FarwayDot/Cooling-System/ConsorcioMedico_Refrigeradora.kicad_pcb

## KiCad design ConsorcioMedico_Refrigeradora.kicad_pcb (2024-01-05)

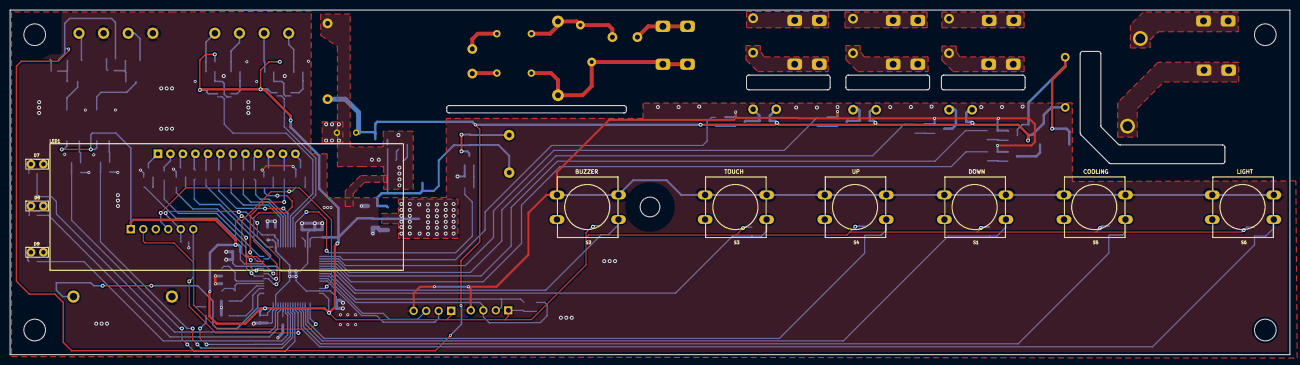
[picture p1: board ConsorcioMedico_Refrigeradora.kicad_pcb from above]

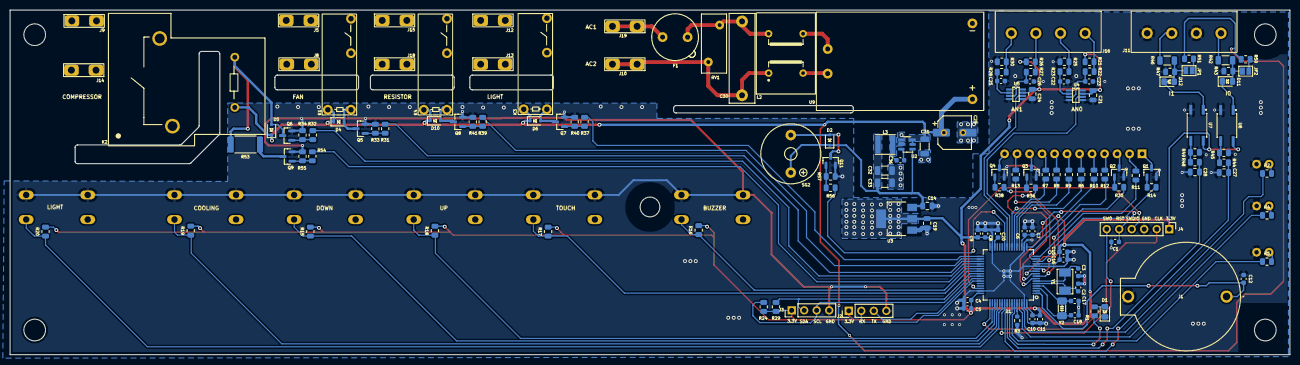
[picture p2: board ConsorcioMedico_Refrigeradora.kicad_pcb from below]

Board: 2 copper layers, 260.0 x 70.0 mm, 156 parts (144 on the bottom side), 116 nets.

Parts:
C1, C4, C6, C8, C10, C12, C15: 100nF 50V; C_0603_1608Metric
C2, C3: 30pF 50V; C_0603_1608Metric
C5, C7, C9, C11: 10nF 50V; C_0603_1608Metric
C14: 1uF 10V; C_0805_2012Metric
C16, C22, C23, C25, C26: 1uF 50V; C_0603_1608Metric
C17, C18: 15pF 10V; C_0603_1608Metric
C19: 4.7uF 5V; C_0805_2012Metric
C20: 2.2uF 50V; C_0603_1608Metric
C21, C24: 100nF 50V; C_0805_2012Metric
C27, C28: 1uF 50V; C_0805_2012Metric
C29: 100uF 25V; CP_Elec_6.3x7.7
C30: 0.1uF 275VAC; C_Rect_L18.0mm_W5.0mm_P15.00mm_FKS3_FKP3
C31: 10uF; C_1206_3216Metric
C32, C33: 22uF; C_1206_3216Metric
C36: 100nF; C_0603_1608Metric
D1: LED_0805
D2, D4, D5, D6, D10: 1N4148WS; D_SOD-323
D7, D8, D9: L-144IDT; LED_3.9x1.9mm
D11, D12: RED; LED_0805
F1: 250VAC 0.5AAC; Fuseholder_TR5_Littelfuse_No560_No460
J1: BatteryHolder; BatteryHolder_DS1092_04_B6P
J2, J3: USART; PinHeader_1x04_P2.54mm_Vertical
J4: SWD; PinHeader_1x06_P2.54mm_Vertical
J5, J8: Evap_fan; Solder-Terminal_FS1536_6.3x0.8mm_NINIGI
J6, J7: Screw_Terminal_01x01; Pad_0.7mm_1.3mm
J9, J14: Compress; Solder-Terminal_FS1536_6.3x0.8mm_NINIGI
J10, J19: AC; Solder-Terminal_FS1536_6.3x0.8mm_NINIGI
J11: Digital; Terminal-Block_XY2500V-B_4P_P5.0mm_XINYA
J12, J13: Light; Solder-Terminal_FS1536_6.3x0.8mm_NINIGI
J15, J18: Resistor; Solder-Terminal_FS1536_6.3x0.8mm_NINIGI
J16: Analog; Terminal-Block_XY2500V-B_4P_P5.0mm_XINYA
JP1, JP2: Bridge1; SolderJumper-2_P1.3mm_Open_Pad1.0x1.5mm
K1, K3, K4: HF46F-G/012-HS1T; Relay_HONGFA_SPST-NO_20.5x7x15.3mm
K2: AZ2150-1A-12DEF; Relay_Zettler_SPST-NO_31.8x26.9x19.1mm
L2: UU9.8-10mH
L3: YNR4030-4R7M 4.7uF; Inductor_YNR4030_4x4x3mm_YJYCOIN
LED1: LFD080AUE-103A-0
Q1, Q2, Q3, Q4: MMBT3904; SOT-23
Q5, Q6, Q7, Q8, Q9, Q11: BSS806; SOT-23
R1, R14, R22, R23, R27, R28, R35, R36, R38, R44, R48: 1k; R_0805_2012Metric
R2, R4, R5: 330; R_0805_2012Metric
R3: 10k; R_0603_1608Metric
R6, R7, R8, R9, R10, R11, R12, R13: 120R; R_0805_2012Metric
R15, R16, R17, R18, R19, R20: 10k; R_0805_2012Metric
R21, R26: 3.9k; R_0805_2012Metric
R24, R29: 2.2k; R_0805_2012Metric
R25, R30: 2.7k; R_0805_2012Metric
R31, R32, R37, R39, R54, R56: 220R; R_0805_2012Metric
R33, R34, R40, R41, R55, R57: 10K; R_0805_2012Metric
R42, R46: 6.2k; R_1206_3216Metric
R43, R47: 2.4k; R_0805_2012Metric
R45, R49: 22k; R_0805_2012Metric
R50, R51: 2k; R_0805_2012Metric
R53: 150R; R_2512_6332Metric
RV1: RM10D561KD24E100; RV_Disc_D12mm_W5.1mm_P7.5mm
S1: Buzz; SW_PUSH-12mm-H
S2: Touch; SW_PUSH-12mm-H
S3: Up; SW_PUSH-12mm-H
S4: Down; SW_PUSH-12mm-H
S5: Cooling; SW_PUSH-12mm-H
S6: Light; SW_PUSH-12mm-H
SG2: F_TMB
U1: STM32F411RETx; LQFP-64_10x10mm_P0.5mm
U2: AP63205WU; TSOT-23-6
U3: LDL1117; SOT-223-3_TabPin2
U4, U5: INA350; SOT-23-8
U6, U7: LTV-357T; SO-4_4.4x3.6mm_P2.54mm
U9: HLK-PMx; HLK-PM12
Y1: 8Mhz; Crystal_SMD_5032-2Pin_5.0x3.2mm
Y2: 32.768khz/12.5pF; Crystal_SMD_3215-2P_32.768khz

Connections:
+3.3V: C4.1, C5.1, C6.1, C7.1, C8.1, C9.1, C10.1, C11.1, C15.1, C16.1, C19.1, C21.1, C24.1, J2.1, J3.1, J4.1, R15.2, R16.2, R17.2, R18.2, R19.2, R20.2, R21.1, R24.2, R26.1, R29.2, U1.13 (VDDA), U1.19 (VDD), U1.32 (VDD), U1.48 (VDD), U1.64 (VDD), U3.2 (VO), U4.7 (V+), U5.7 (V+), U6.4, U7.4
+5V: C14.1, C32.1, C33.1, D2.1 (K), L3.2, SG2.+, U2.1 (FB), U3.3 (VI)
+12V: C29.1, C31.1, D4.1 (K), D5.1 (K), D6.1 (K), D10.1 (K), J6.1, K1.2, K2.2, K3.2, K4.2, R50.2, R51.2, U2.2 (EN), U2.3 (IN), U9.3 (+)
+BATT: C12.1, J1.1, U1.1 (VBAT)
A: R13.1, U1.14 (PA0)
B: R12.1, U1.15 (PA1)
Button_Buzzer: R16.1, S2.1, U1.38 (PC7)
Button_Cooling: R19.1, S5.1, U1.53 (PC12)
Button_Down: R15.1, S1.1, U1.52 (PC11)
Button_Light: R20.1, S6.1, U1.54 (PD2)
Button_Touch: R17.1, S3.1, U1.39 (PC8)
Button_Up: R18.1, S4.1, U1.51 (PC10)
C: R11.1, U1.16 (PA2)
D: R10.1, U1.17 (PA3)
DIG1: R14.1, U1.11 (PC3)
DIG2: R35.1, U1.10 (PC2)
DIG3: R36.1, U1.9 (PC1)
DIG4: R38.1, U1.8 (PC0)
DIG_IN_0: C27.1, R44.2, U1.56 (PB4)
DIG_IN_1: C28.1, R48.2, U1.57 (PB5)
DP: R6.1, U1.23 (PA7)
E: R9.1, U1.20 (PA4)
F: R8.1, U1.21 (PA5)
G: R7.1, U1.22 (PA6)
GND: C1.2, C2.2, C3.2, C4.2, C5.2, C6.2, C7.2, C8.2, C9.2, C10.2, C11.2, C12.2, C14.2, C15.2, C16.2, C17.2, C18.2, C19.2, C20.2, C21.2, C22.2, C23.2, C24.2, C25.2, C26.2, C27.2, C28.2, C29.2, C31.2, C32.2, C33.2, D1.1 (K), D7.K, D8.K, D9.K, J1.2, J2.4, J3.4, J4.3, J7.1, J11.2, J11.4, Q1.2 (E), Q2.2 (E), Q3.2 (E), Q4.2 (E), Q5.2 (S), Q6.2 (S), Q7.2 (S), Q8.2 (S), Q9.2 (S), Q11.2 (S), R3.2, R25.2, R30.2, R33.1, R34.1, R40.1, R41.1, R43.2, R45.2, R47.2, R49.2, R55.1, R57.1, S1.3, S1.4, S2.3, S2.4, S3.3, S3.4, S4.3, S4.4, S5.3, S5.4, S6.3, S6.4, U1.12 (VSSA), U1.18 (VSS), U1.31 (VSS), U1.47 (VSS), U1.63 (VSS), U2.4 (GND), U3.1 (ADJ), U4.4 (V-), U4.5 (REF), U5.4 (V-), U5.5 (REF), U6.2, U7.2, U9.4 (-)
I0: J11.1, R42.1
I1: J11.3, R46.1
I2C3_SCL: J3.3, R24.1, U1.41 (PA8)
I2C3_SDA: J3.2, R29.1, U1.40 (PC9)
LED_Defrost: R2.1, U1.62 (PB9)
LED_Door: R4.1, U1.61 (PB8)
LED_Status: R1.1, U1.58 (PB6)
LED_TempAlarm: R5.1, U1.59 (PB7)
MCU_RX1: J2.2, U1.43 (PA10)
MCU_TX1: J2.3, U1.42 (PA9)
unnamed: C30.1, F1.2, L2.4, RV1.1
unnamed: D1.2 (A), R1.2
unnamed: D2.2 (A), Q11.3 (D), SG2.-
unnamed: D4.2 (A), K1.1, Q5.3 (D)
unnamed: D5.2 (A), K2.1, Q6.3 (D), R53.1
unnamed: D6.2 (A), K3.1, Q7.3 (D)
unnamed: D7.A, R2.2
unnamed: D8.A, R4.2
unnamed: D9.A, R5.2
unnamed: D10.2 (A), K4.1, Q8.3 (D)
unnamed: D11.2 (A), JP2.2 (B), R42.2, R43.1
unnamed: D11.1 (K), U6.1
unnamed: D12.2 (A), JP1.2 (B), R46.2, R47.1
unnamed: D12.1 (K), U7.1
unnamed: J5.1, K1.4
unnamed: J8.1, K1.3
unnamed: J9.1, K2.4
unnamed: C30.2, J10.1, L2.1, RV1.2
unnamed: J12.1, K3.4
unnamed: J13.1, K3.3
unnamed: J14.1, K2.3
unnamed: J15.1, K4.4
unnamed: J16.1, R21.2, R22.1
unnamed: J16.2, R23.1, R25.1
unnamed: J16.3, R26.2, R27.1
unnamed: J16.4, R28.1, R30.1
unnamed: J18.1, K4.3
unnamed: F1.1, J19.1
unnamed: JP1.1 (A), R51.1
unnamed: JP2.1 (A), R50.1
unnamed: LED1.11 (A), R13.2
unnamed: LED1.4 (B), R12.2
unnamed: LED1.2 (C), R11.2
unnamed: LED1.5 (D), R10.2
unnamed: LED1.1 (DIG1), Q1.3 (C)
unnamed: LED1.3 (DIG2), Q2.3 (C)
unnamed: LED1.10 (DIG3), Q3.3 (C)
unnamed: LED1.12 (DIG4), Q4.3 (C)
unnamed: LED1.6 (DP), R6.2
unnamed: LED1.7 (E), R9.2
unnamed: LED1.8 (F), R8.2
unnamed: LED1.9 (G), R7.2
unnamed: Q1.1 (B), R14.2
unnamed: Q2.1 (B), R35.2
unnamed: Q3.1 (B), R36.2
unnamed: Q4.1 (B), R38.2
unnamed: Q5.1 (G), R31.2, R33.2
unnamed: Q6.1 (G), R32.2, R34.2
unnamed: Q7.1 (G), R37.2, R40.2
unnamed: Q8.1 (G), R39.2, R41.2
unnamed: Q9.3 (D), R53.2
unnamed: Q9.1 (G), R54.2, R55.2
unnamed: Q11.1 (G), R56.2, R57.2
unnamed: R44.1, R45.1, U6.3
unnamed: R48.1, R49.1, U7.3
unnamed: R3.1, U1.60 (BOOT0)
unnamed: C18.1, U1.3 (PC14), Y2.2
unnamed: C17.1, U1.4 (PC15), Y2.1
unnamed: C2.1, U1.5 (PH0), Y1.1
unnamed: C3.1, U1.6 (PH1), Y1.2
unnamed: C20.1, U1.30 (VCAP1)
unnamed: C36.2, U2.6 (BST)
unnamed: C36.1, L3.1, U2.5 (SW)
unnamed: C23.1, R22.2, U4.3 (+)
unnamed: C22.1, R23.2, U4.2 (-)
unnamed: C26.1, R27.2, U5.3 (+)
unnamed: C25.1, R28.2, U5.2 (-)
unnamed: L2.3, U9.1 (AC1)
unnamed: L2.2, U9.2 (AC2)
RESET: C1.1, J4.5, U1.7 (NRST)
RTD1: U1.24 (PC4), U4.6
RTD2: U1.25 (PC5), U5.6
Relay_Calefac: R39.1, U1.34 (PB13)
Relay_Compressor: R32.1, U1.36 (PB15)
Relay_Compressor_Save: R54.1, U1.37 (PC6)
Relay_Fan: R31.1, U1.35 (PB14)
Relay_Light: R37.1, U1.33 (PB12)
Relay_On: R56.1, U1.26 (PB0)
SWCLK: J4.2, U1.49 (PA14)
SWDIO: J4.4, U1.46 (PA13)
SWO: J4.6, U1.55 (PB3)
