FarwayDot/Cooling-System/(commit log)

2023-12-28 Primer commit con el proyecto vacío
    [ConsorcioMedico_Refrigeradora.kicad_pcb, ConsorcioMedico_Refrigeradora.kicad_sch]
2023-12-28 SCH: Se añadió el uC, pulsadores, display, fuente, relays (aunque falta escoger el correcto)
    [ConsorcioMedico_Refrigeradora.kicad_sch]
2023-12-29 Commit de guardado
    [ConsorcioMedico_Refrigeradora.kicad_sch]
2023-12-30 SCH: Aún queda resolver la entrada digital para el switch y la fuente de voltaje. PCB: Se están acomodando los componentes
    [ConsorcioMedico_Refrigeradora.kicad_pcb, ConsorcioMedico_Refrigeradora.kicad_sch]
2023-12-30 SCH: Se guarda antes de crer las hojas jerárquicas
    [ConsorcioMedico_Refrigeradora.kicad_sch]
2023-12-30 SCH: Falta definir los capacitores de entrada, colocar el footprint del diodo e inductor. PCB: Falta acomodar algunos componentes.
    [Analog.kicad_sch, ConsorcioMedico_Refrigeradora.kicad_pcb, ConsorcioMedico_Refrigeradora.kicad_sch, Dig_Inputs.kicad_sch, Dig_Outputs.kicad_sch, Relay.kicad_sch]
2024-01-02 SCH: Se cambió el IRM, se colocó filtro en la entrada AC, se modificó la fuente switching LM, se corrigieron algunos errores de diseño. PCB: Se terminó el placement de los componentes
    [Analog.kicad_sch, ConsorcioMedico_Refrigeradora.kicad_pcb, ConsorcioMedico_Refrigeradora.kicad_sch, Dig_Inputs.kicad_sch, Dig_Outputs.kicad_sch, Relay.kicad_sch]
2024-01-02 Se guarda avance
    [ConsorcioMedico_Refrigeradora.kicad_pcb, ConsorcioMedico_Refrigeradora.kicad_sch, Relay.kicad_sch]
2024-01-03 SCH: Se cambian la bornera por terminales, se añade un disparo más para el compressor (falta conectarlo al uC), falta modificar, se cambia la fuente switching por otra de menos costo
    [ConsorcioMedico_Refrigeradora.kicad_pcb, ConsorcioMedico_Refrigeradora.kicad_sch, Relay.kicad_sch]
2024-01-03 SCH: Se modificó la posición de algunos pines para mejorar la calidad del ruteado. PCB: Se enruta las señales, quedando la alimentación, pines de programación, relays y planos de gnd
    [Analog.kicad_sch, ConsorcioMedico_Refrigeradora.kicad_pcb, ConsorcioMedico_Refrigeradora.kicad_sch, Dig_Inputs.kicad_sch]
2024-01-04 SCH: Se añadieron pads en el capacitor de la fuente principal en caso de que el de tipo SMD no dure mucho. PCB: Se enrutó, se colocaron los planos GND, se acomodó la serigrafía
    [ConsorcioMedico_Refrigeradora.kicad_pcb, ConsorcioMedico_Refrigeradora.kicad_sch]
2024-01-04 SCH: Se modicaron algunos valores y comentarios del sch. PCB: Posiblemente debido a jlcpcb. JLCPCB: Se asigna el código para la soldura
    [ConsorcioMedico_Refrigeradora.kicad_pcb, ConsorcioMedico_Refrigeradora.kicad_sch, Dig_Outputs.kicad_sch]
2024-01-05 SCH: Se arregló la posición de los pulsadores, se agrega buzzer, PCB: Se revisan los componentes y se agrega serigrafía. JLCPCB: Actualizado
    [ConsorcioMedico_Refrigeradora.kicad_pcb, ConsorcioMedico_Refrigeradora.kicad_sch, Dig_Inputs.kicad_sch, Dig_Outputs.kicad_sch]
2024-01-05 SCH: pin EN se corrige para activar la alimentación de 5V, se cambia el empaquetado de varias resistencias 0603 a 0805. PCB: Se alarga el plano de GND, se acomodan los componentes 0805, se completa d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
    [ConsorcioMedico_Refrigeradora.kicad_pcb, ConsorcioMedico_Refrigeradora.kicad_sch, Dig_Inputs.kicad_sch, Dig_Outputs.kicad_sch]
2024-01-05 PCB: Se ajusta el ancho de pista a 4mm del compressor
    [ConsorcioMedico_Refrigeradora.kicad_pcb]
